tzim999/FlyShaker/README.md

# FlyShaker
An open-source ESP32-based vibration controller for Drosophila behavioral experiments. Generates programmable mechanical stimulation with deterministic timing, host-controlled protocols, and accelerometer feedback for sleep deprivation, learning, memory, and arousal studies.
