tzim999/FlyShaker/controller-board.odp

Fly Shaker Controller Board

ESP32-WROOM

30 pin Dev Board

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
3.3v

USB C to

Host Controller + Power

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
RESET

ADXL345

Accelerometer

GND

Vcc

CS

SDO(MISO)

SDA(MOSI)

SCL(SCLK)

*Wire Notation:

BLU = blue solid

BLU/ = blue/white

DAC OUTPUT

GND

+5v out

ACC_MOSI

ACC_MISO

ACC_SCLK

ACC_CS

+3.3v out

CAT-5 Cable*

BLU,BRN,OR GND

GN +3.3v

GN/ ACC_CS

BRN/ ACC_MISO

OR/ ACC_MOSI

BLU/ ACC_SCLK

Com Status

Shaker Status

Power Status

Blue LED

Red LED

330 ohm

330 ohm

+3.3v

Green LED

330 ohm

USB C

BOOT

Thomas G. Zimmerman 9-14-26
