tzim999/FlyShaker/controller-board.png

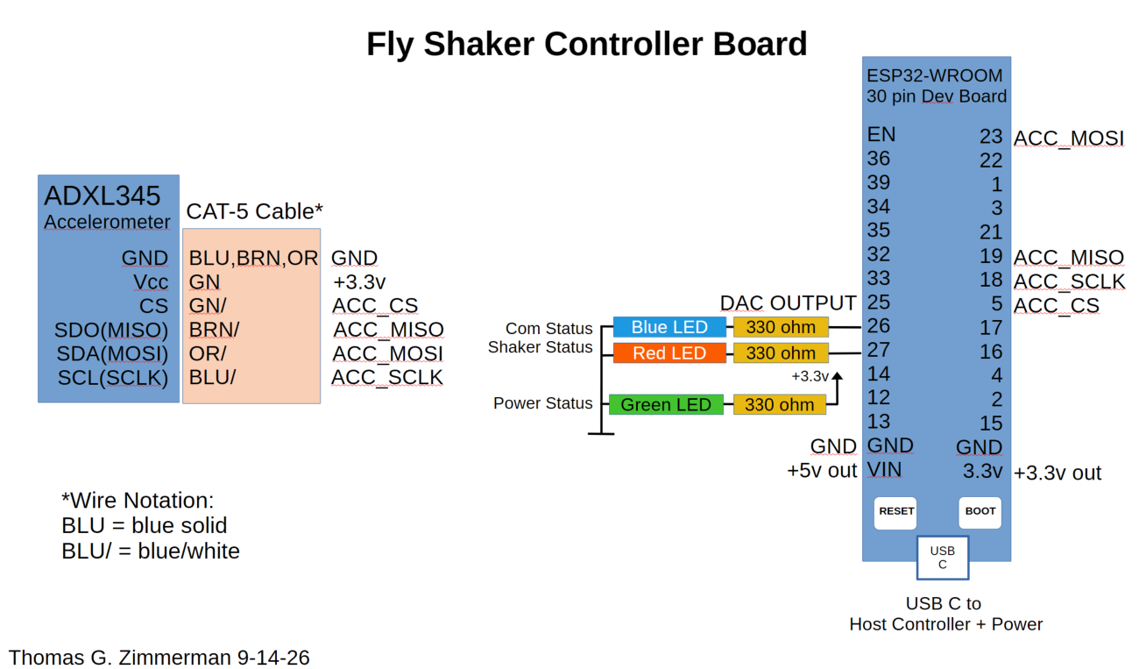
controller-board.png
