tzim999/FlyShaker/dac-output-buffer.png

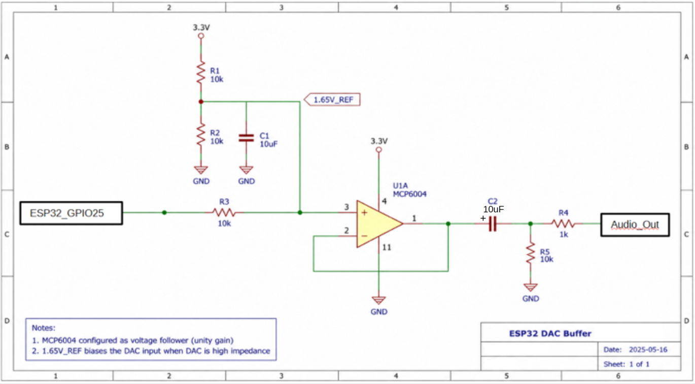
dac-output-buffer.png
