tzim999/FlyShaker/(commit log)

2026-07-24 Add files via upload
    The Fly Shaker Python Terminal is the host application used to configure and operate the Fly Shaker. It discovers and connects to the ESP32, loads or edits stimulation protocols, downloads protocol parameters, starts and stops experiments, displays system status and accelerometer measurements, and saves or reloads protocols. The terminal manages experiment setup while the ESP32 executes all real-time waveform generation and timing.
2026-07-24 Add files via upload
    The Fly Shaker ESP32 firmware is the real-time controller for the Fly Shaker. It receives stimulation protocols from the host computer, validates protocol parameters, generates DAC waveforms, executes burst, sequence, and session timing, acquires accelerometer measurements, and reports system status over USB serial. All real-time waveform generation and timing are performed locally on the ESP32, ensuring precise and repeatable mechanical stimulation regardless of host computer performance.
2026-07-24 Add files via upload
    Using the Fly Shaker ESP32 Firmware and Python Terminal
    Overview
    The Fly Shaker software is divided into two cooperating programs. The ESP32 firmware performs all real-time waveform generation, timing, and accelerometer acquisition. The Python Terminal provides the user interface for configuring protocols, downloading parameters, starting and stopping experiments, and monitoring the system. The separation ensures deterministic timing on the ESP32 while allowing the host computer to perform higher-level tasks such as vision processing and data logging.
2026-07-24 ESP32 audio output buffer
    The ESP32 DAC output is buffered by an MCP6004 unity-gain voltage follower, with its input weakly biased to a filtered 1.65 V mid-supply reference so that the op-amp input remains at a defined voltage when the DAC enters its high-impedance state during reset, eliminating hum and noise.
2026-07-24 Shaker Signal Generator using ESP32 Wiring Table
    This document lists all electrical connections for the Fly Shaker hardware, including the ESP32, MCP6004 analog output buffer, ADXL345 accelerometer, status LEDs, and power connections. It serves as the reference for wiring, debugging, and verifying the hardware before assembly. The table is synchronized with the accompanying schematic and identifies each ESP32 pin, its function, the connected device, and implementation notes.
2026-09-14 Create fly-shaker-user-guide.md
    Converted user guide from ODT to Markdown.
    Clarified protocol table entries for session duration, amplitude scaling/polarity, and AC-coupled output behavior.
2026-09-14 Add files via upload
    ESP32 DAC output buffer schematic showing the 1.65 V mid-supply reference, MCP6004 unity-gain buffer, AC coupling, and audio amplifier interface.
2026-09-14 Delete DAC-output-buffer.png
    Incorrect DAC output pin
2026-09-14 Delete Shaker ESP32 Audio Output.png
    needs updates
2026-09-14 Add files via upload
    Corrected ESP DAC output pin (ESP32_GPIO25).
    Increased C2 to 10 uF to make lower rolloff freq (with R5=10k resistor fc~1.59Hz) for less low-freq attenuation.
    Changed Audio_In to Audio_Out
2026-09-14 Add files via upload
    Replaced Fly Shaker Wiring Document with drawing. Created in LibreOffice Impress and image captured as .png.
2026-09-14 Delete roboshaker-controller.odp
    Replaced wiring table with drawing
2026-09-14 Add files via upload
    Replaced wiring table with drawing.
